hjgode/avr_splmeter_arduino/splmeter_fft/splmeter_fft.odt

### A simple Sound Pressure Level Meter (SPL) dB audio meter using AVR ATmega

Updated to version 02.

What is proposed here is a SPL db meter using and AVR Atmega micro.

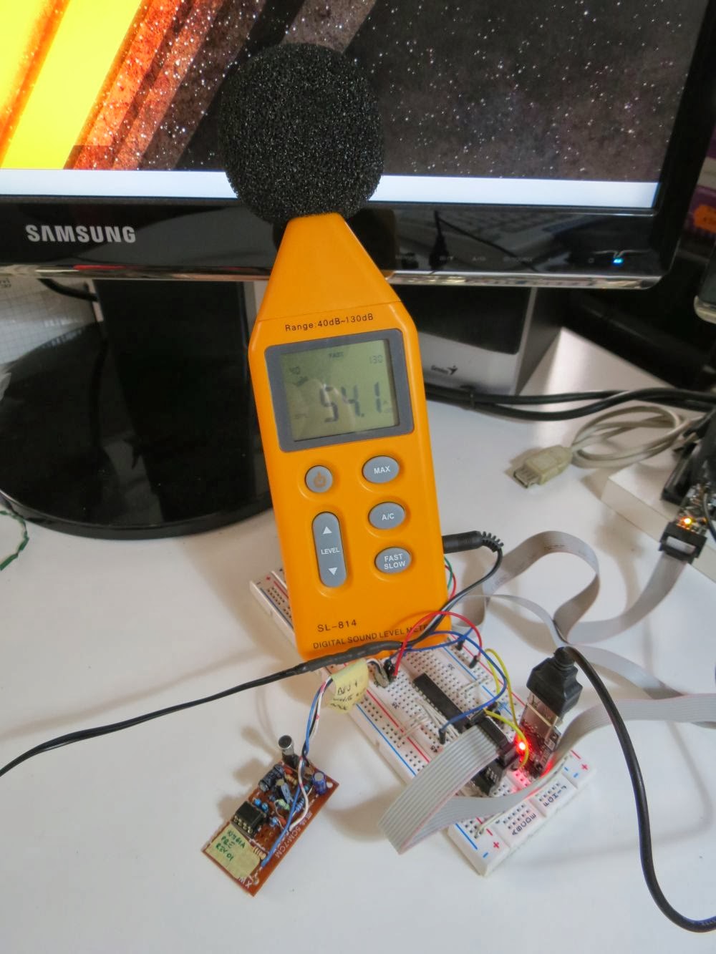
[picture p1: figure]

(http://1.bp.blogspot.com/-dWMSYalnrXo/UwMvXjbpsbI/AAAAAAAAEAw/E39ixhhqgCw/s1600/splmeter_atmega_01.jpg)

A sound level meter or sound meter is an instrument which measures sound pressure level. Sound pressure level (SPL) or sound level is a logarithmic measure of the effective sound pressure of a sound relative to a reference value. It is measured in decibels (dB) above a standard reference level. The commonly used reference sound pressure in air is = 20 µPa (rms) which is usually considered the threshold of human hearing. Keep in mind that 1 pascal will equal an SPL of 94 dB. Because the frequency response of human hearing changes with amplitude, a weighting have been established for measuring sound pressure. Usually the A-weighting curve is used. A weighting curve is a graph of gain across the frequency range (10Hz to 20kHz).

SPL level is defined as

(http://3.bp.blogspot.com/-D7KvuR2YHBk/UwMva3ANVQI/AAAAAAAAEBE/nHSDwBU26_Q/s1600/CodeCogsEqn_1.jpg)

given p_rms as the sound pressure measured, and p_ref as the reference sound pressure.

Once we have got the RMS value of the signal (actualRMS), we can transform it to SPLdb using this formula:

(http://2.bp.blogspot.com/-vX4CbVYjh7s/UwMvbNbp-qI/AAAAAAAAEBM/GwpNpSmQvkg/s1600/CodeCogsEqn_2.jpg)

given refRMS as the reference RMS value for the input board at a know refSPLdb SPLdb level.

To compute SPL measurements, the meters loop is:

1. collects N samples
2. do FFT for the N samples collected, the signal is now transformed in the frequency domain
3. apply A-weighting (in freq domain)
4. get magnitude of the signal
5. get RMS value of the signal
6. apply a time-weight filter to RMS value
7. compute the SPL using the RMS value
8. output data

Every sample is collected at a fixed time, a timer interrupt impose this timing, this is because we need to know the sampler frequency, to built filters and output signal magnitude.
Runnig @16Mhz i'm able to collect samples at almost 22050Hz.

For FFT i've used Radix-4 FFT library you can find it here http://davidegironi.blogspot.it/2013/06/avr-atmega-audio-input-rma-using-fft.html.

The method to weighting the signal proposed here just use a weight table that contains the weight of the signal in the frequency domain, this table shoud be FFT size/2, because we can retain frequencies below Nyquist rate.

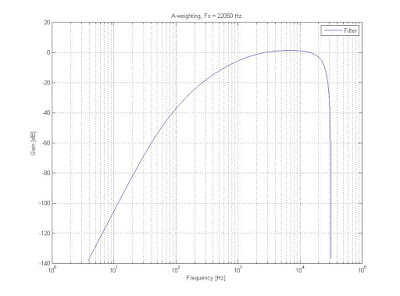
[picture p2: figure]

(https://1.bp.blogspot.com/-GkwPPYuGG9A/WbBm0h0DdfI/AAAAAAAALB0/vwLnS1a5kqkl-de5DrAXjv6TBi56XEM8wCKgBGAs/s1600/aweighting_frequancyresponse.jpg)

A matlab script to check this filter method is used.
The picture above is the frequency reponse graph of the A-Weighting curve used.
The picture below compares the values of SPL for the unfiltered signal (blue), A-weighting filtered signal using the matlab "filter" function (green), A-weighting filtered signal using the weight table method (red).
As you can see, matlab native "filter" function and weight table method almost response in the same way.

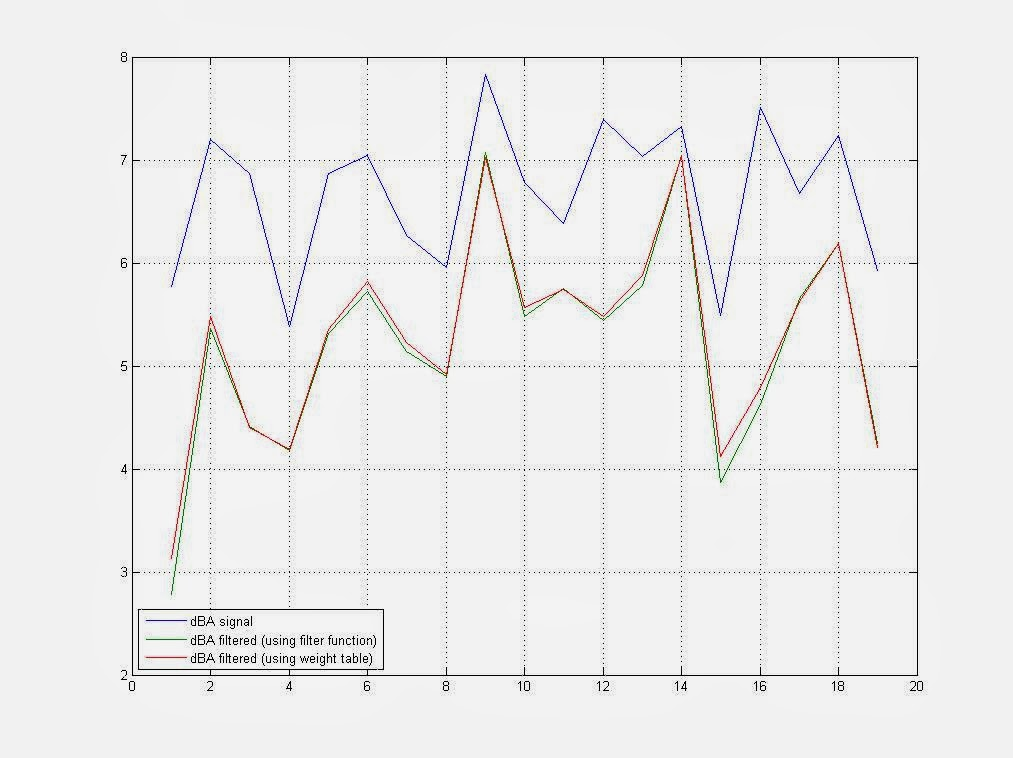
[picture p3: figure]

(http://2.bp.blogspot.com/-nQWasfQ75IM/UwMvcz97PpI/AAAAAAAAEB0/X62QFA03ZFc/s1600/aweighting_compared.jpg)

Once we have got the A-weighted signal we can compute the RMS value for the signal.
To obtain RMS value of the AC current of the audio signal processed, from which you can get the SPL db value, we use the Parseval's theorem for FFT so for fft size of N (look at the Radix-4 FFT library link above for further information)

(http://2.bp.blogspot.com/-71gRE2hSFV0/UwMvb2B-tXI/AAAAAAAAEBo/wlm9DL-BLqk/s1600/CodeCogsEqn_5.jpg)

An SPL meter also needs the signal to be time-weighted. Time-weightings have been internationally standardised, 'S' (1 s) originally called Slow, 'F' (125 ms originally called Fast and 'I' (35 ms) originally called Impulse.
A time-weight is a RC filter, exponential averaging is equivalent to a simple RC filter

(http://1.bp.blogspot.com/-ClTUwJsqAcg/UwMvbPI8SgI/AAAAAAAAEBQ/gaRlzCIu3ZI/s1600/CodeCogsEqn_3.jpg)

Y is the RMS signal global, and Ynew is the RMS signal computed every step.
alpha effects the filter speed, it has to be a number between 1 and 0.
We can define alpha so that it depends on the sample frequency Fs and the windows size W. A good estimation could be

(http://2.bp.blogspot.com/-9e-1XuGg8rE/UwMvbdR2IFI/AAAAAAAAEBc/RZsYQYqsXL8/s1600/CodeCogsEqn_4.jpg)

In my code, i've use another estimation for alpha, it seams to me better to consider the number of cycles needed to collect the N samples, i've call this number fsc, said this, my alpha was estimated as

(http://4.bp.blogspot.com/-eQVWt4a6pyk/UwMvb93f-wI/AAAAAAAAEBk/FherDtasKyQ/s1600/CodeCogsEqn_6.jpg)

Now that the signal is windowed, we can compute SPL using the above definition:

(http://2.bp.blogspot.com/-vX4CbVYjh7s/UwMvbNbp-qI/AAAAAAAAEBM/GwpNpSmQvkg/s1600/CodeCogsEqn_2.jpg)

The input microphone preamp board proposed here is a derivation of the John Conover WM-61A preamp. The reference is the schematic-6 found here: Using the Panasonic WM61A as a Measurement Microphone (John Conover) (http://www.johncon.com/john/wm61a/).
This board is stated 306uV RMS at ~32db.

Using an ebay SPL meter, and a scope, i've found that my board implementation should be 315uV at ~32db (which is next to 306uV as stated in the referecence audio board schematics).

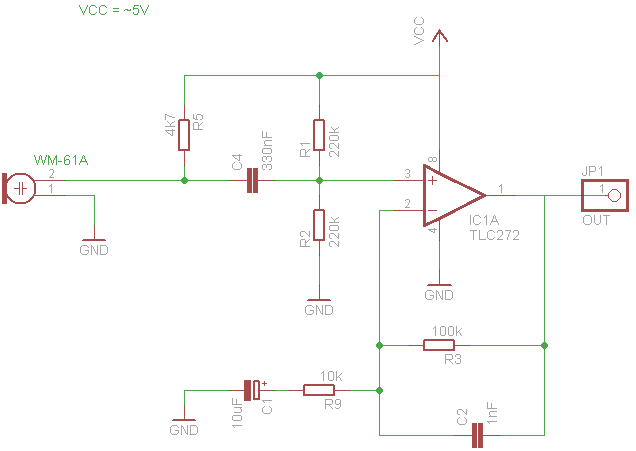
[picture p4: figure]

(http://4.bp.blogspot.com/-3rIxcpsj82A/UwMveNYRF6I/AAAAAAAAECI/D7XipNHTRLg/s1600/wm61a_premini_rev03.png)

Two http://processing.org/ scripts are provided as a viewer for the data.
The screenshot below shows one of them, it also show you the spectrum of the input signal.

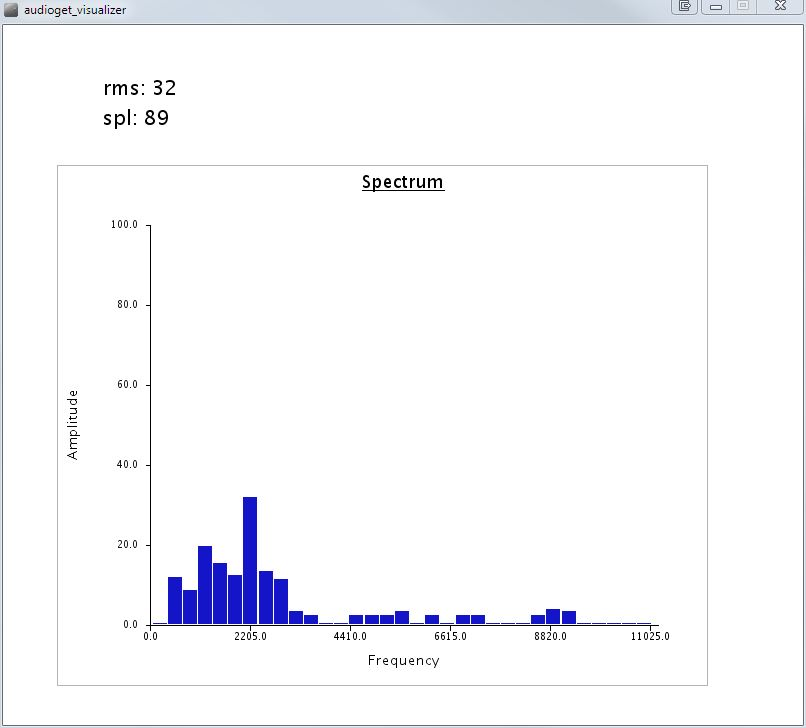
[picture p5: figure]

(http://1.bp.blogspot.com/-78dRr-AU4zM/UwMvdn3FGnI/AAAAAAAAEB4/1jHXz17DyRI/s1600/screenshot_spectrum_analyzer.jpg)

I'm not a DSP expert, so method proposed here can be improved, for example it is possible to implement the A-weighting filter in time domain, becuse it can be used as a IIR filter, this will prevent the use of the FFT computation for the signal, saving microcontroller resources.

Also, if you want to help me, send me feedback if you:

- you've got any better input board circuit
- you've found bugs in my software implementation

This project is build on an ATmega8 running at 16Mhz, compiled with avrgcc, using Eclipse IDE

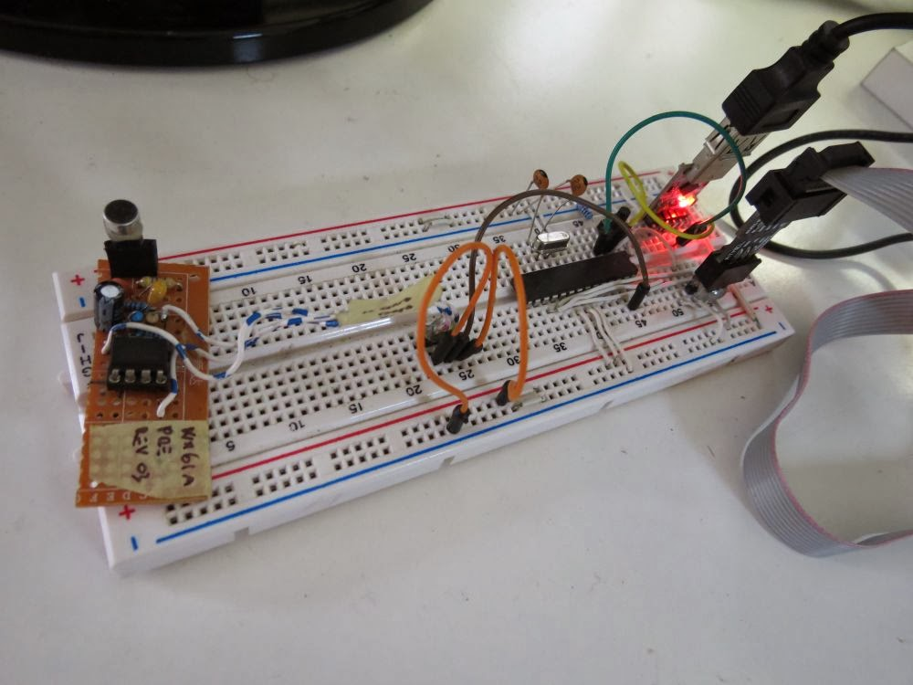
[picture p6: figure]

(http://3.bp.blogspot.com/-dkRcylpiP5c/UwMvY8iu9iI/AAAAAAAAEA4/_Frpcyzwi0o/s1600/splmeter_atmega_02.jpg)

ChangeLog

- 02b: main.c strict compile error fixed, function audioget_getrmsval now called the right way (thanks to Emmanuel Pierre for reporting this bug)
- 02: weighting function bug fix, weighting now applied on both the real and imaginary part of the fft (thanks to Xiaofeng for reporting this bug).
- 01: first version.

Code

- avr_splmeter_02b.zip (https://sourceforge.net/projects/davidegironi/files/avr-splmeter/avr_splmeter_02b.zip/download)
- ~~avr_splmeter_02.zip~~ (https://sourceforge.net/projects/davidegironi/files/avr-splmeter/avr_splmeter_02.zip/download)
- ~~avr_splmeter_01.zip~~ (https://sourceforge.net/projects/davidegironi/files/avr-splmeter/avr_splmeter_01.zip/download)

Notes

- read risk disclaimer
- excuse my bad english
