hjgode/avr_splmeter_arduino/(commit log)

2016-07-31 It compiles in Arduino IDE 1.6.5
    for Nano (Atmega 328/168) and "Atmega8 Optiboot"
2016-08-01 changed adc.h to use VCC as VREF
2016-08-23 working. added some comments about db and volttage
2016-08-23 added original avr_splmeter 02b code and files
    [aweightingtableI.xls, aweightingtableR.xls, wm61a_premini_rev03.sch]
2016-08-23 added latest uartlibrary.zip and added information about setup of code for electret microphone sensivity etc.
2018-02-10 added corrected code of original spl_meter with uartlib and prog_int16_t fix
    [aweightingtableI.xls, aweightingtableR.xls, wm61a_premini_rev03.sch]
